DavidMFlynn/Tethered_Joy/Grip/STL/JoyPlate.stl

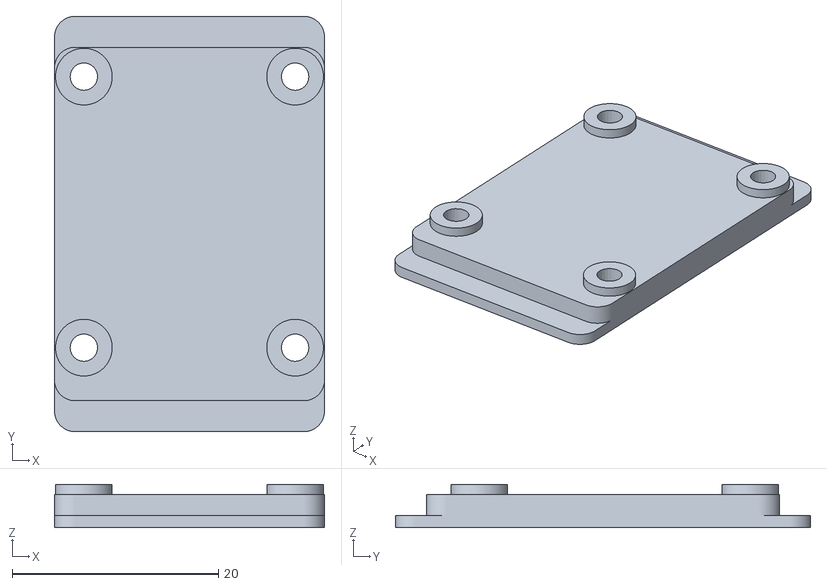
[picture p1: CAD file, 2019-04-28]
Grip/STL/JoyPlate.stl
26.2 x 40.3 x 4.20
