DavidMFlynn/Tethered_Joy/Grip/STL/Grip.stl

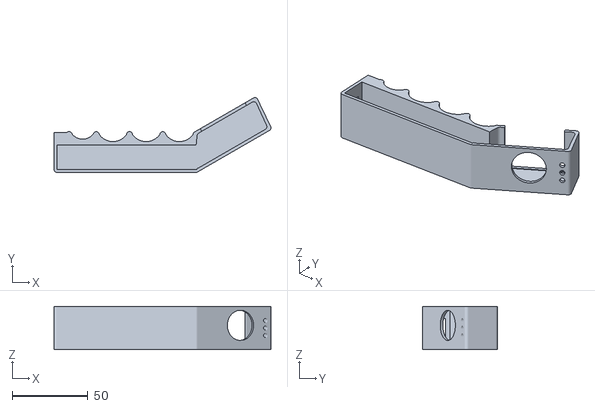
[picture p2: CAD file, 2019-04-28]
Grip/STL/Grip.stl
143.6 x 49.5 x 28.5
