DavidMFlynn/Tethered_Joy/User Guide.txt.pdf

/Projects/TetheredJoy/Tethered_Joy/User Guide.txt | Page 1/1
Saved: 6/10/19, 3:20:28 PM | Printed for: David Flynn
1 | TTL Serial connected to a USB to Serial.¬
2 | ¬
3 | Uses TTL serial from a USB to 5 volt TTL serial converter to interface a joystick ¬
4 | with buttons and LEDs.¬
5 | Packet serial is used to give each device a unique address. ¬
6 | ¬
7 | Communication:¬
8 | 38,400 baud, 8 data, 1 stop, no parity.¬
9 | To connect multiple Serial Devices to a single connection add a 4.7KΩ resistor to the¬
10 | Rx line of the USB to serial converter, a.k.a. the common Tx line of the Serial Servos.¬
11 | ¬
12 | Packet Serial:¬
13 | All packets are 6 bytes w/o optional sync bytes and checksum:¬
14 | Source Address, Destination Address and 4 data bytes¬
15 | or¬
16 | 0xDD,0xDD,Source Address, Destination Address and 4 data bytes, Checksum ¬
17 | (XOR of Source Addr, Dest Addr, 4 Data bytes)¬
18 | ¬
19 | Default master address is 1¬
20 | Default slave address is 2¬
21 | ¬
22 | All commands return something. ¬
23 | Some return a data packet (Slave,Master,Data0,Data1,Data2,Data3,CSum),¬
24 | others return only a single byte (0xFF) as an acknowledgment.¬
25 | ¬
26 | Commands:¬
27 | ==========================================================================================¬
28 | kCmd_SetMode(0x81) | +1 data (SysMode), return ACK¬
29 | kCmd_GetMode(0x01)¬
30 | kCmd_GetJoy(0x82) | Return X,Y,Btn,HBtn¬
31 | kCmd_SetLEDs(0x83) | +1 data (JoyLEDs), return ACK¬
32 | ¬
33 | kCmd_SaveParams(0x94) | Save all eeprom params, return ACK¬
34 | kCmd_RestoreParams(0x95) Copy to ram, return ACK¬
35 | kCmd_ReBoot(0x99) | ReBoot the controller¬
36 | kCmd_RunBootloader(0x9A) Set EEPROM (0xFF) = 0xFF and reboot¬
37 | ¬
38 | ; these commands save params and return a 0,0,0,0 packet with the new address¬
39 | kCmd_SetMasterAddr(0xA1) +1 data, return a zero packet¬
40 | kCmd_SetSlaveAddr(0xA2) +1 data, return a zero packet¬
41 | ;¬
42 | ;Special packet (0xDD, 0xDD, 0x01, 0x02, 0xAA, 0x00, 0x00, 0x00, checksum)¬
43 | kCmd_SendIDString(0xAA) returns "DMFE T-Joy\n"¬
44 | ¬
45 | ;---JoyLEDs bits---¬
46 | JoyLEDsD4R | EQU | 0¬
47 | JoyLEDsD4G | EQU | 1¬
48 | JoyLEDsD5R | EQU | 2¬
49 | JoyLEDsD5G | EQU | 3¬
50 | JoyLEDsD2 | EQU | 4¬
51 | JoyLEDsD3 | EQU | 5¬
52 | JoyLEDsD6 | EQU | 6¬
53 | ¬
54 | ; Currently Active¬
55 | #Define | SW1_Flag | SwitchFlags,0¬
56 | #Define | SW2_Flag | SwitchFlags,1¬
57 | #Define | SW3_Flag | SwitchFlags,2¬
58 | #Define | SW4_Flag | SwitchFlags,3¬
59 | #Define | JoySW_Flag | SwitchFlags,4¬
60 | ;¬
61 | ; History Flags, cleared by reading¬
62 | #Define | SW1_HFlag | SwitchHFlags,0¬
63 | #Define | SW2_HFlag | SwitchHFlags,1¬
64 | #Define | SW3_HFlag | SwitchHFlags,2¬
65 | #Define | SW4_HFlag | SwitchHFlags,3¬
66 | #Define | JoySW_HFlag | SwitchHFlags,4¬
67
