DavidMFlynn/Tethered_Joy/PCB/TetheredJoy.sch.pdf

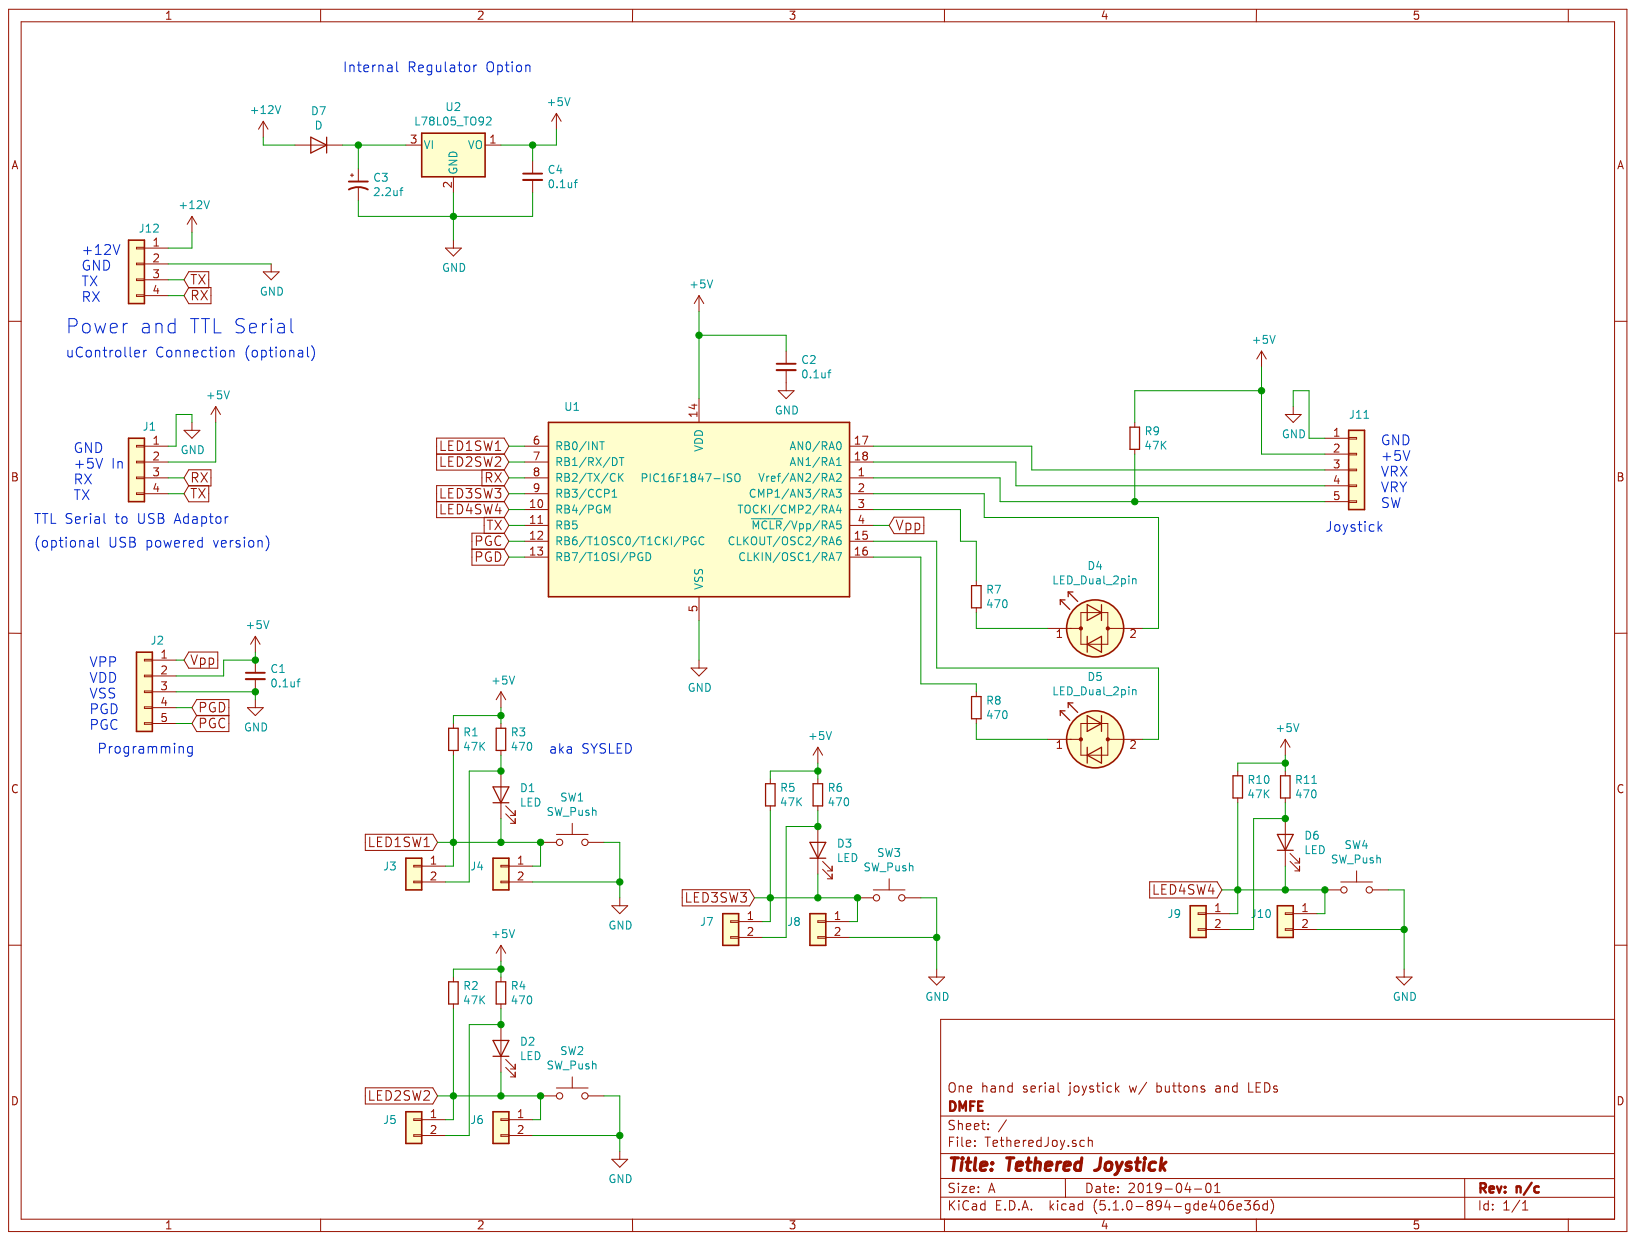
[picture p3: page 1]
