DavidMFlynn/Tethered_Joy/PCB/TetheredJoy.kicad_pcb

## KiCad design PCB/TetheredJoy.kicad_pcb (2019-06-08)

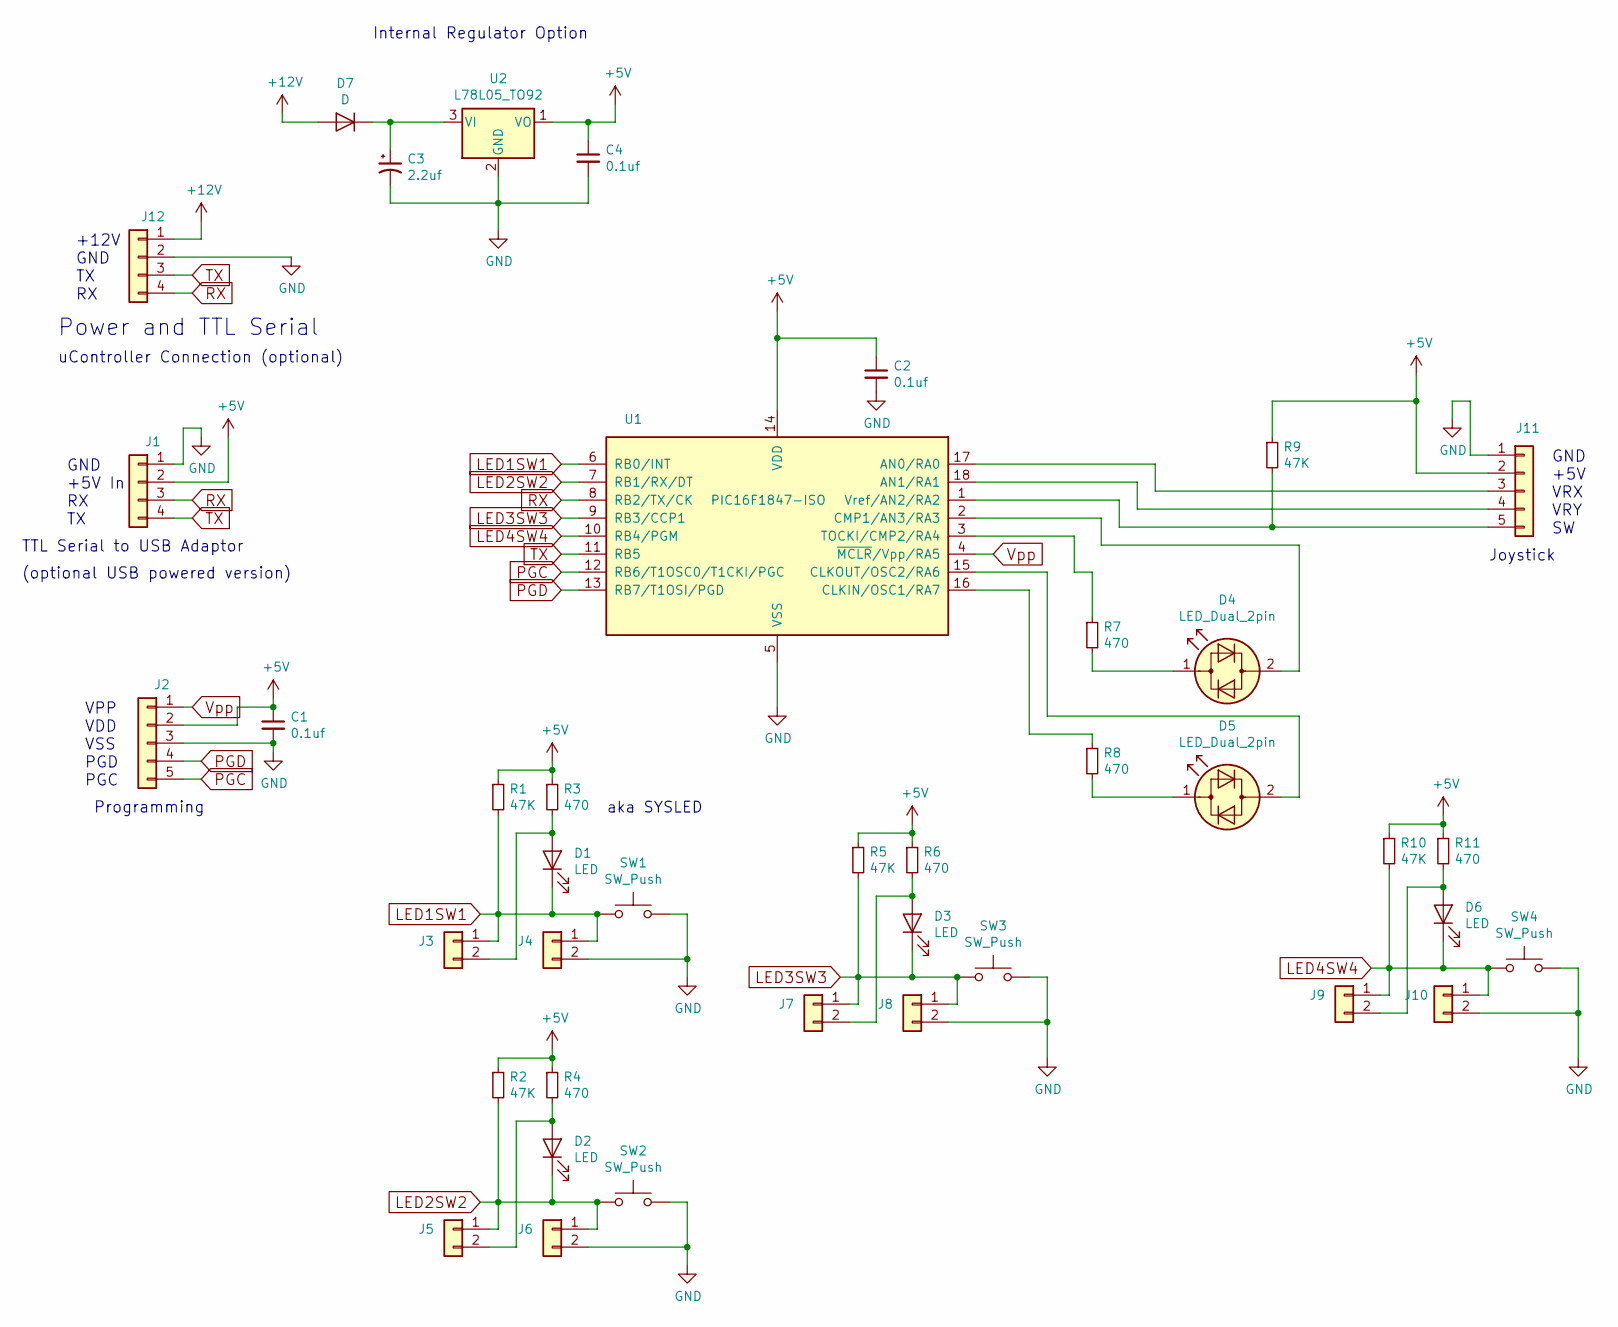
[picture p4: schematic TetheredJoy.sch, Tethered Joystick]

Parts:
C1, C2, C4: 0.1uf; C_0805_2012Metric_Pad1.15x1.40mm_HandSolder
C3: 2.2uf; CP_Radial_D4.0mm_P2.00mm
D1, D2, D3, D6: LED; LED_1206_3216Metric_Pad1.42x1.75mm_HandSolder
D4, D5: LED_Dual_2pin; LED_1206_3216Metric_Pad1.42x1.75mm_HandSolder
D7: D; D_SMA_Handsoldering
J1, J12: Conn_01x04; PinHeader_1x04_P2.54mm_Vertical
J2, J11: Conn_01x05; PinHeader_1x05_P2.54mm_Vertical
J3, J4, J5, J6, J7, J8, J9, J10: Conn_01x02; PinHeader_1x02_P2.54mm_Vertical
R1, R2, R5, R9, R10: 47K; R_0805_2012Metric_Pad1.15x1.40mm_HandSolder
R3, R4, R6, R7, R8, R11: 470; R_0805_2012Metric_Pad1.15x1.40mm_HandSolder
SW1, SW2, SW3, SW4: SW_Push; SW_SPST_PTS645
U1: PIC16F1847-ISO; SOIC-18W_7.5x11.6mm_P1.27mm
U2: L78L05_TO92; TO-92_Inline

Connections:
+5V: C1.1, C2.1, C4.1, J1.2, J2.2, J11.2, R1.1, R2.1, R3.1, R4.1, R5.1, R6.1, R9.1, R10.1, R11.1, U1.14 (VDD), U2.1 (VO)
+12V: D7.2 (A), J12.1
GND: C1.2, C2.2, C3.2, C4.2, J1.1, J2.3, J4.2, J6.2, J8.2, J10.2, J11.1, J12.2, SW1.2, SW2.2, SW3.2, SW4.2, U1.5 (VSS), U2.2 (GND)
LED1SW1: D1.1 (K), J3.1, J4.1, R1.2, SW1.1, U1.6 (RB0/INT)
LED2SW2: D2.1 (K), J5.1, J6.1, R2.2, SW2.1, U1.7 (RB1/RX/DT)
LED3SW3: D3.1 (K), J7.1, J8.1, R5.2, SW3.1, U1.9 (RB3/CCP1)
LED4SW4: D6.1 (K), J9.1, J10.1, R10.2, SW4.1, U1.10 (RB4/PGM)
unnamed: C3.1, D7.1 (K), U2.3 (VI)
unnamed: D1.2 (A), J3.2, R3.2
unnamed: D2.2 (A), J5.2, R4.2
unnamed: D3.2 (A), J7.2, R6.2
unnamed: D4.1 (KA), R7.2
unnamed: D4.2 (AK), U1.2 (CMP1/AN3/RA3)
unnamed: D5.1 (KA), R8.2
unnamed: D5.2 (AK), U1.15 (CLKOUT/OSC2/RA6)
unnamed: D6.2 (A), J9.2, R11.2
unnamed: J11.3, U1.17 (AN0/RA0)
unnamed: J11.4, U1.18 (AN1/RA1)
unnamed: J11.5, R9.2, U1.1 (Vref/AN2/RA2)
unnamed: R7.1, U1.3 (TOCKI/CMP2/RA4)
unnamed: R8.1, U1.16 (CLKIN/OSC1/RA7)
PGC: J2.5, U1.12 (RB6/T1OSC0/T1CKI/PGC)
PGD: J2.4, U1.13 (RB7/T1OSI/PGD)
RX: J1.3, J12.4, U1.8 (RB2/TX/CK)
TX: J1.4, J12.3, U1.11 (RB5)
Vpp: J2.1, U1.4 (~MCLR~/Vpp/RA5)

Notes on the sheet:
GND +5V In RX TX
VPP VDD VSS PGD PGC
TTL Serial to USB Adaptor
Programming
Joystick
GND +5V VRX VRY SW
aka SYSLED
+12V GND TX RX
Power and TTL Serial
uController Connection (optional)
(optional USB powered version)
Internal Regulator Option

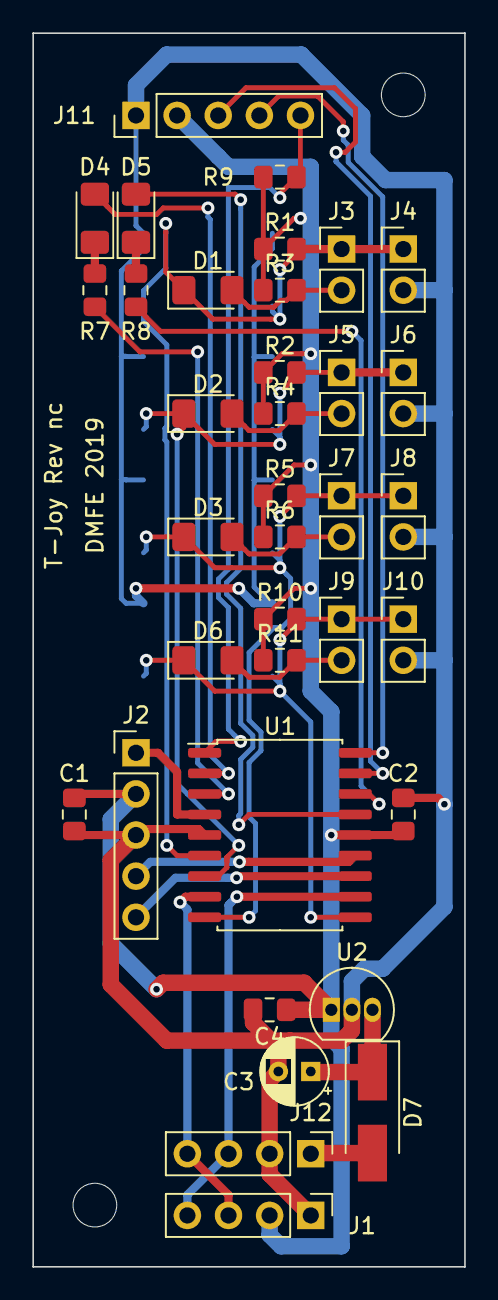
[picture p5: board TetheredJoy.kicad_pcb from above]

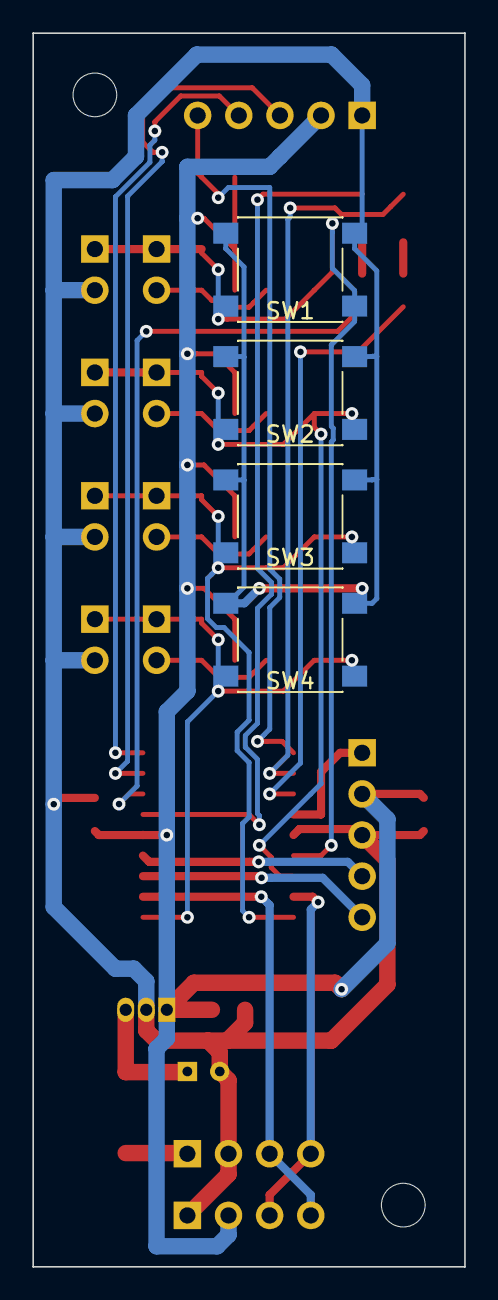
[picture p6: board TetheredJoy.kicad_pcb from below]

Board: 2 copper layers, 26.7 x 76.2 mm, 42 parts (4 on the bottom side), 26 nets.

Other parts of the board:
H1, H2: MountingHole_2.7mm_M2.5
