DavidMFlynn/Tethered_Joy/(commit log)

2019-04-07 Starting the PCB
    [TetheredJoy.kicad_pcb, TetheredJoy.sch]
2019-04-25 worked on schematic
    [TetheredJoy.sch]
2019-04-26 Schematic done
    [TetheredJoy.kicad_pcb, TetheredJoy.sch]
2019-04-29 Left grip
    [Grip.scad]
2019-06-08 PCB done
    [TetheredJoy-B_Cu.gbl, TetheredJoy-B_Mask.gbs, TetheredJoy-Edge_Cuts.gm1, TetheredJoy-F_Cu.gtl, TetheredJoy-F_Mask.gts, TetheredJoy-F_SilkS.gto, TetheredJoy-NPTH.drl, TetheredJoy-PTH.drl]
2019-06-10 Leds working
2019-08-05 schematic pdf
